smartfriendz/smartcore/images/smartcore-top.jpg

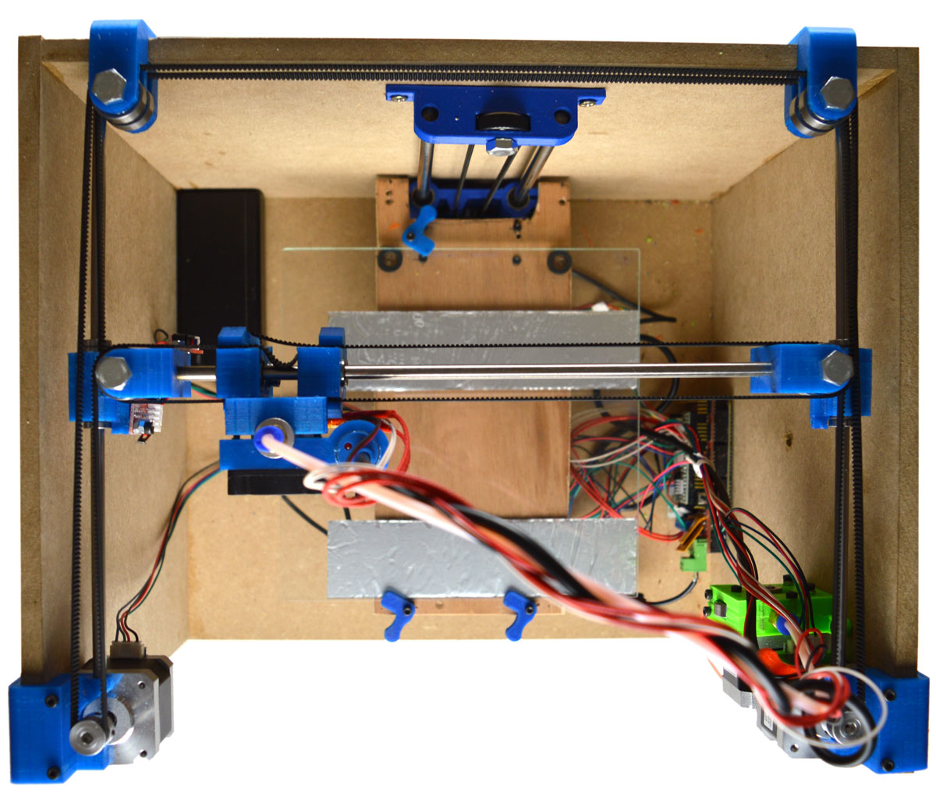
images/smartcore-top.jpg
