smartfriendz/smartcore/images/smartcore-tete.jpg

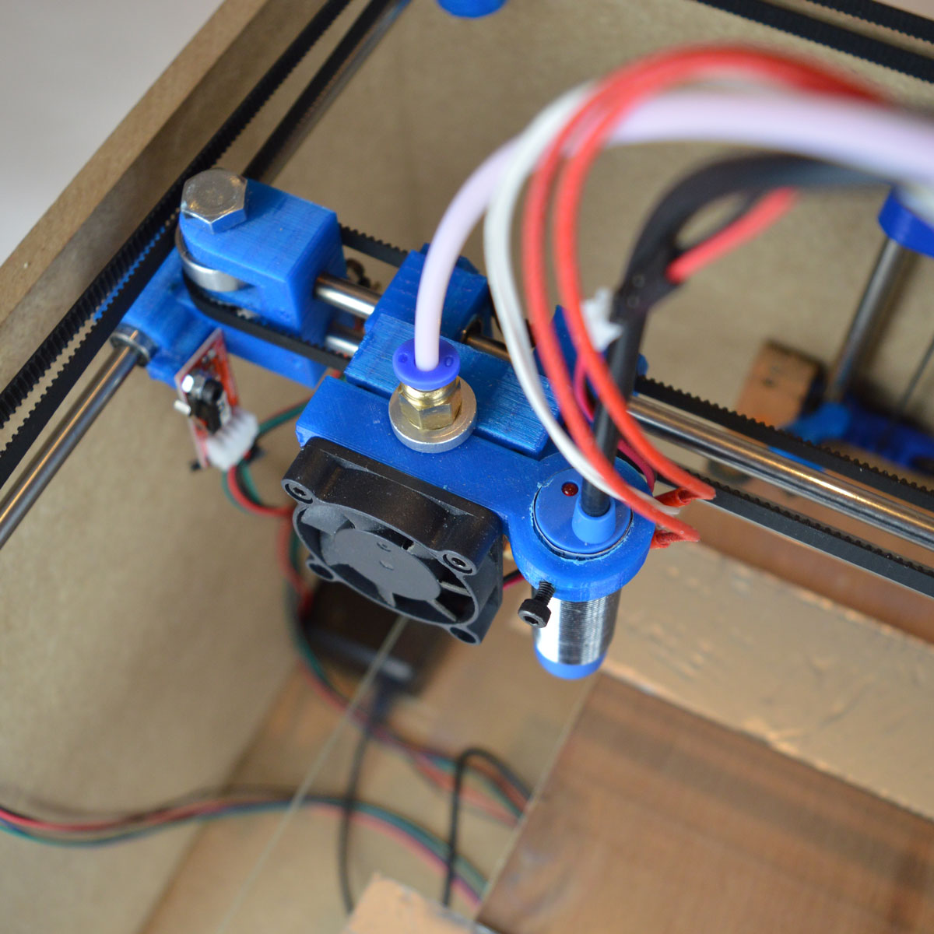
images/smartcore-tete.jpg
