smartfriendz/smartcore/README.md

# smartcore
the simple and cheap corexy from smartfriendz
