smartfriendz/smartcore/images/smartcore diagonal.jpg

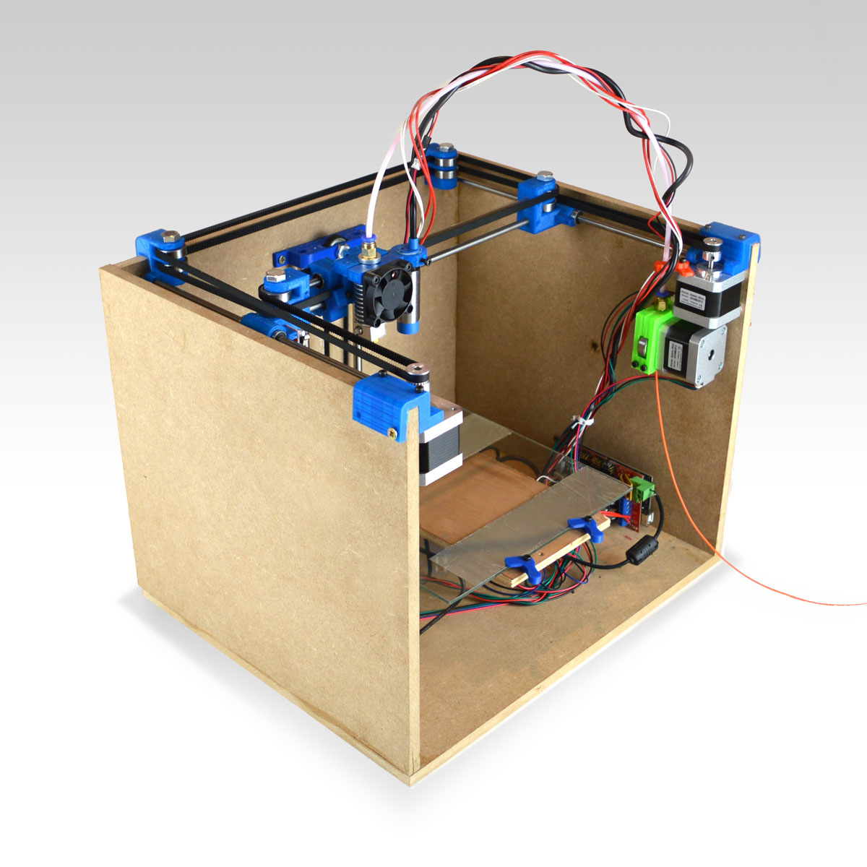
images/smartcore diagonal.jpg
