smartfriendz/smartcore/images/smartcore-front 220.jpg

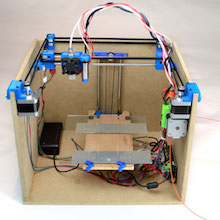
images/smartcore-front 220.jpg
