smartfriendz/smartcore/images/smartcore-sfeer.jpg

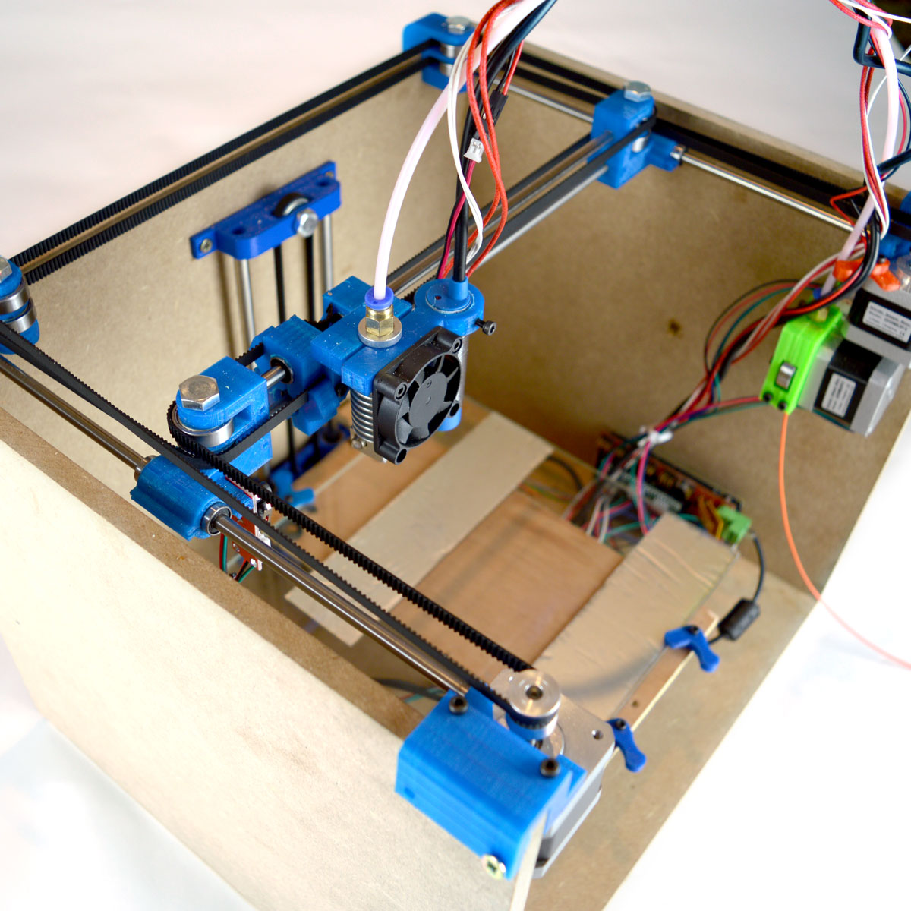
images/smartcore-sfeer.jpg
