smartfriendz/smartcore/stl/separate parts/head_8mmrods.stl

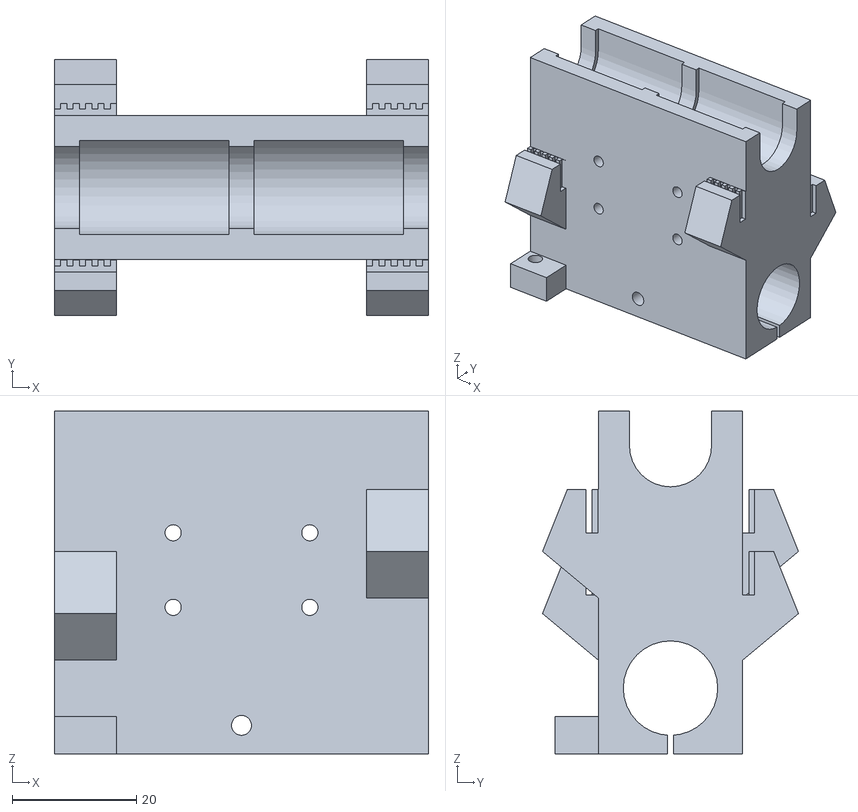
[picture p6: CAD file, 2015-06-15]
stl/separate parts/head_8mmrods.stl
60.2 x 41.2 x 55.2
