smartfriendz/smartcore/stl/smartrapcore_plate3.stl

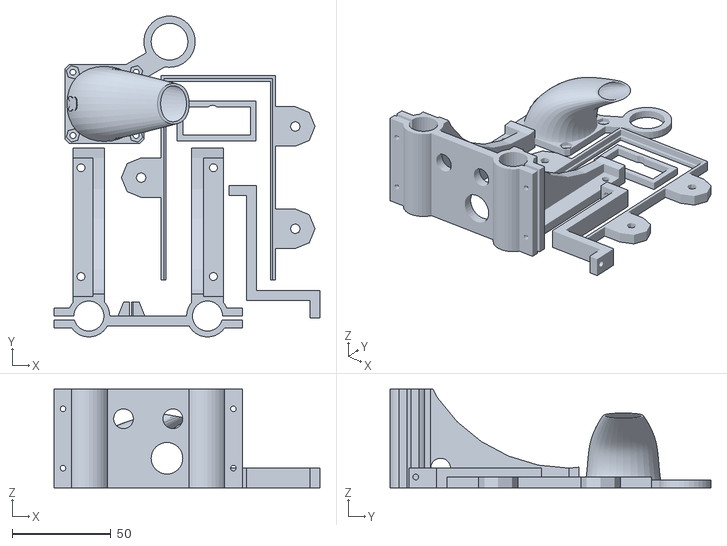
[picture p7: CAD file, 2015-06-17]
stl/smartrapcore_plate3.stl
134.5 x 162.4 x 50.0
