smartfriendz/smartcore/stl/separate parts/Zslide.stl

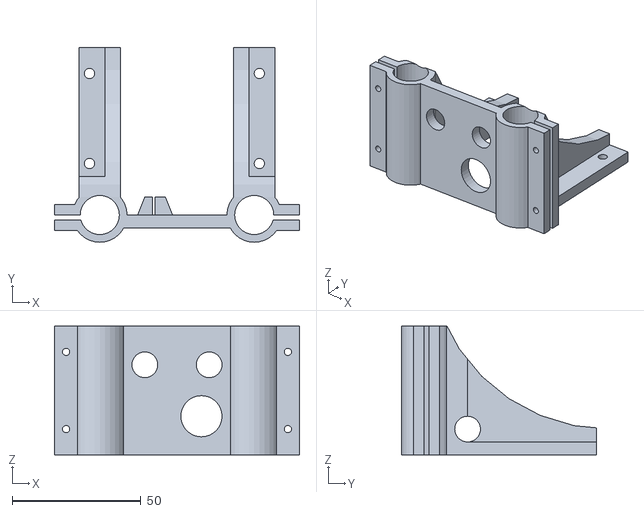
[picture p8: CAD file, 2015-06-10]
stl/separate parts/Zslide.stl
95.2 x 75.6 x 50.0
