smartfriendz/smartcore/stl/smartrapcore_plate1.stl

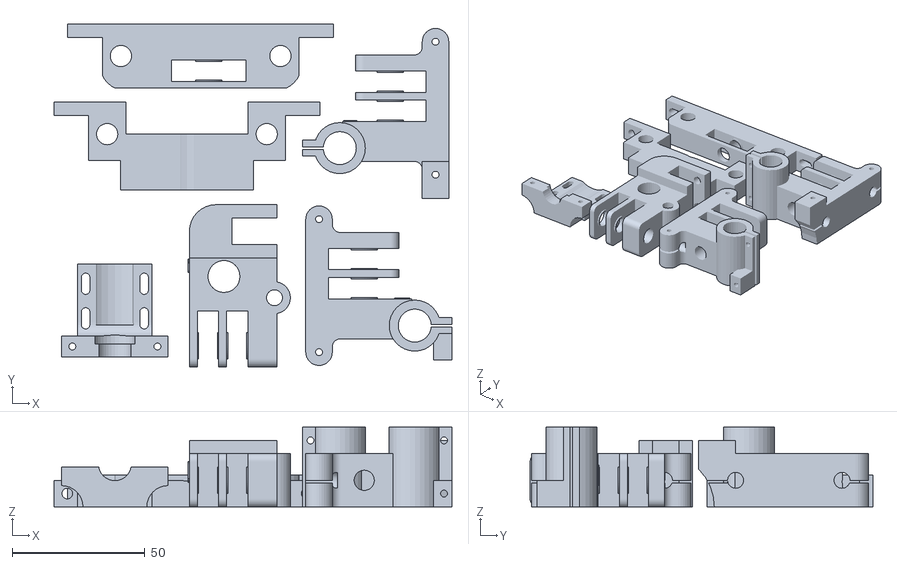
[picture p9: CAD file, 2015-06-17]
stl/smartrapcore_plate1.stl
149.7 x 128.9 x 30.0
