smartfriendz/smartcore/stl/separate parts/extruder_mk8_bottom.stl

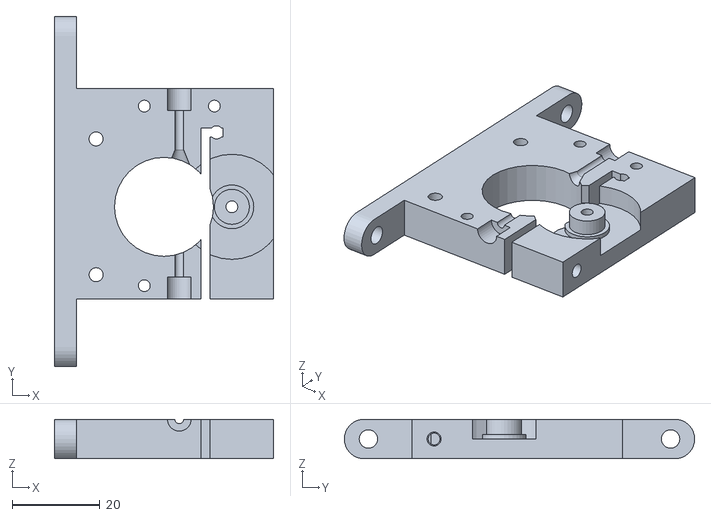
[picture p10: CAD file, 2015-06-10]
stl/separate parts/extruder_mk8_bottom.stl
50.0 x 80.0 x 9.00
