smartfriendz/smartcore/stl/smartrapcore_plate2.stl

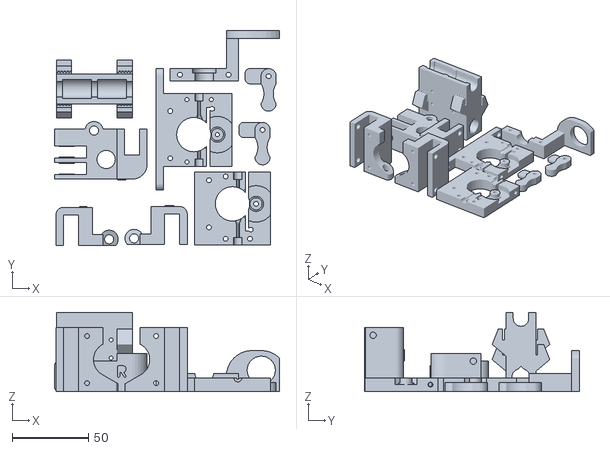
[picture p11: CAD file, 2015-06-17]
stl/smartrapcore_plate2.stl
148.0 x 141.2 x 52.0
