smartfriendz/smartcore/stl/separate parts/spoolholder32.stl

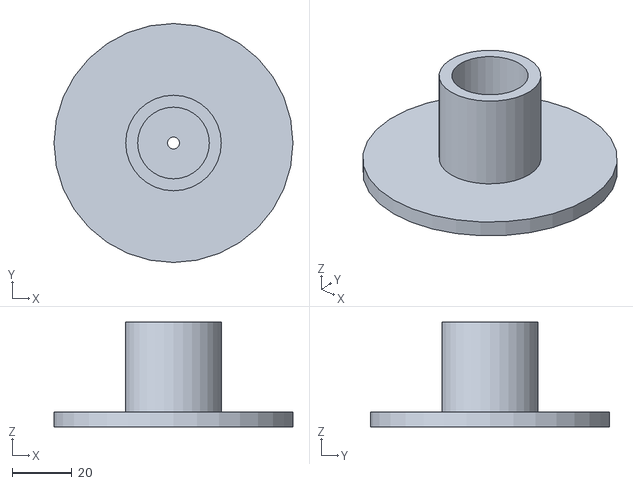
[picture p12: CAD file, 2015-06-10]
stl/separate parts/spoolholder32.stl
80.0 x 80.0 x 35.0
