smartfriendz/smartcore/stl/separate parts/extruder_mk8_top.stl

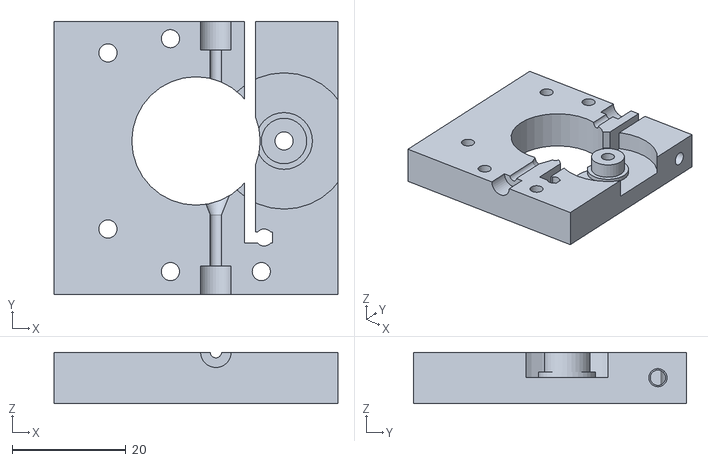
[picture p13: CAD file, 2015-06-10]
stl/separate parts/extruder_mk8_top.stl
50.0 x 48.0 x 9.00
