smartfriendz/smartcore/stl/separate parts/Yslide_left.stl

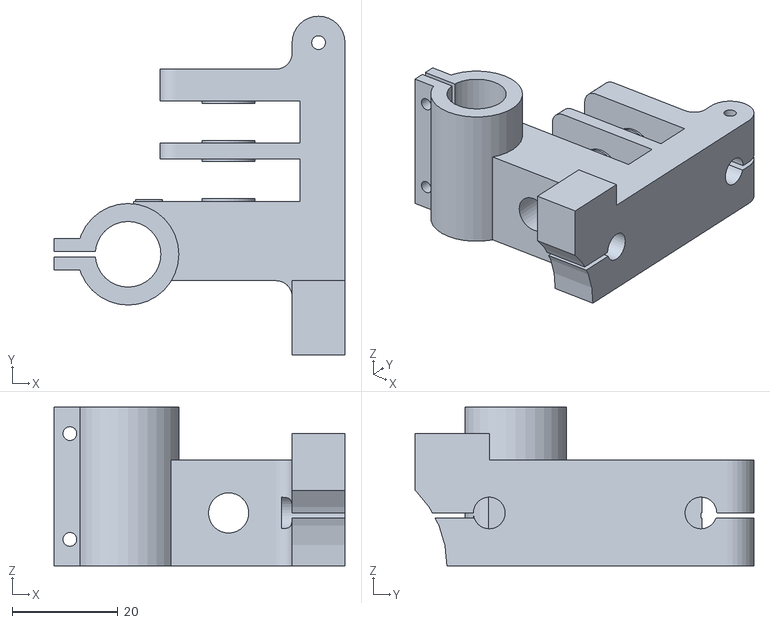
[picture p14: CAD file, 2015-06-10]
stl/separate parts/Yslide_left.stl
55.0 x 64.0 x 30.0
