smartfriendz/smartcore/stl/separate parts/Yslide_right.stl

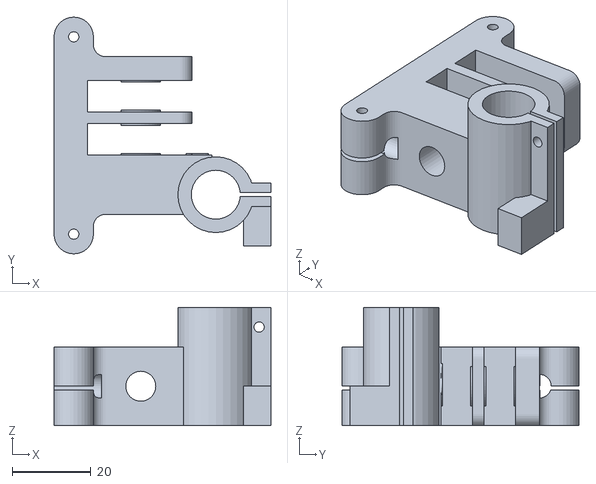
[picture p15: CAD file, 2015-05-28]
stl/separate parts/Yslide_right.stl
55.0 x 60.0 x 30.0
