smartfriendz/smartcore/stl/separate parts/supportcable bigsize.stl

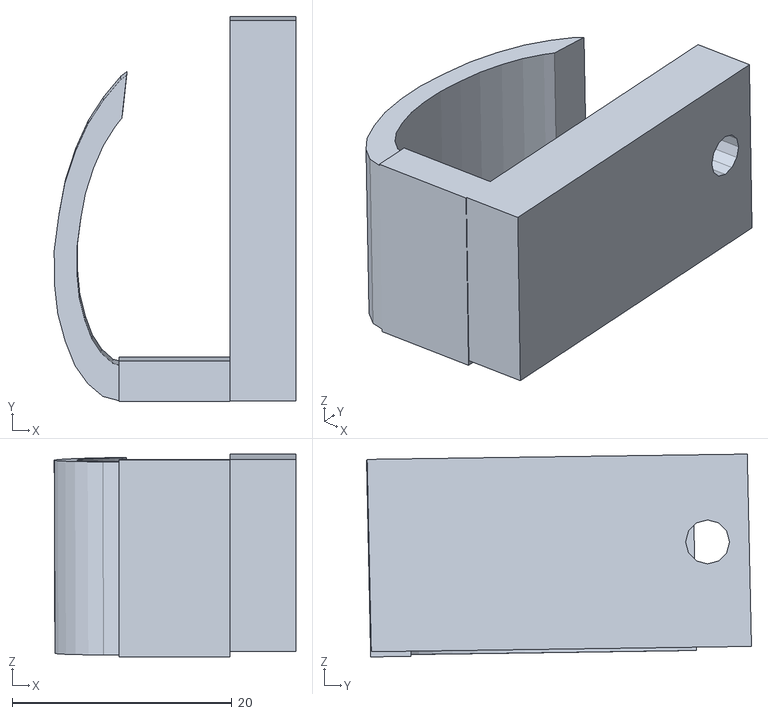
[picture p16: CAD file, 2015-05-28]
stl/separate parts/supportcable bigsize.stl
22.0 x 35.1 x 18.5
