smartfriendz/smartcore/stl/separate parts/ramps_support.stl

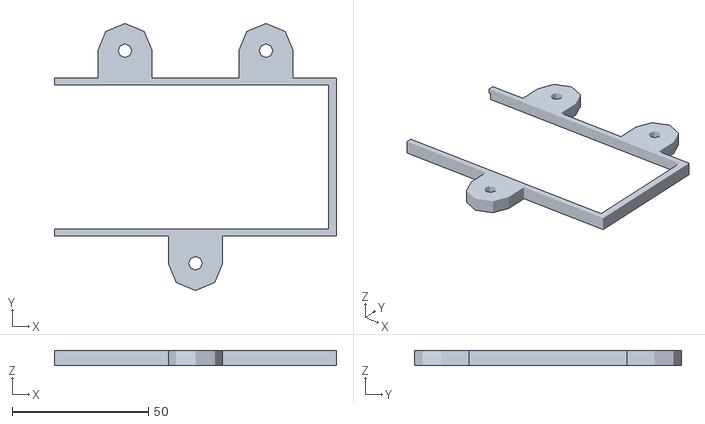
[picture p17: CAD file, 2015-05-28]
stl/separate parts/ramps_support.stl
103.5 x 98.0 x 5.50
