smartfriendz/smartcore/stl/separate parts/head.stl

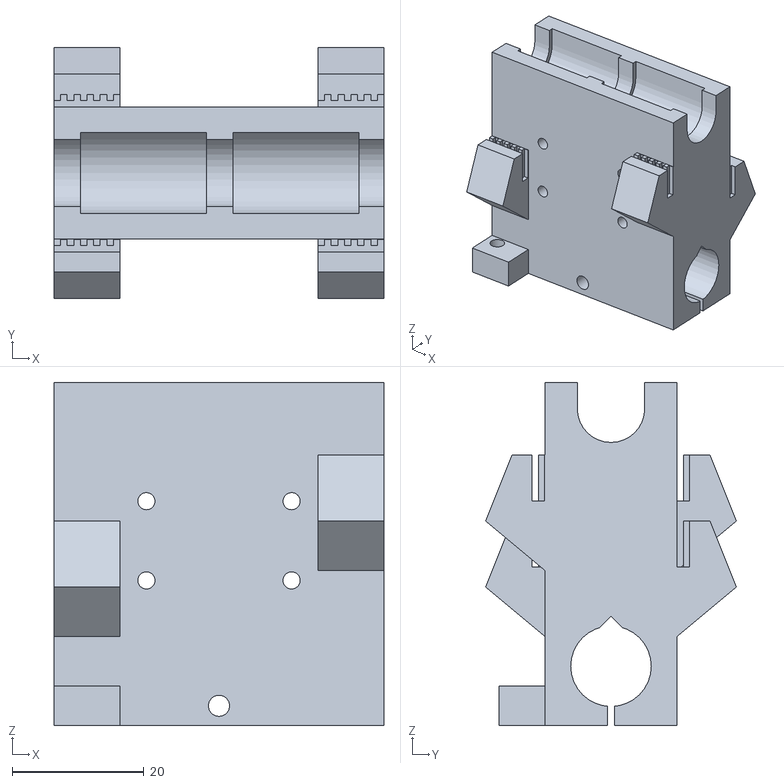
[picture p18: CAD file, 2015-05-28]
stl/separate parts/head.stl
50.0 x 38.0 x 52.0
