smartfriendz/smartcore/stl/separate parts/fixalim.stl

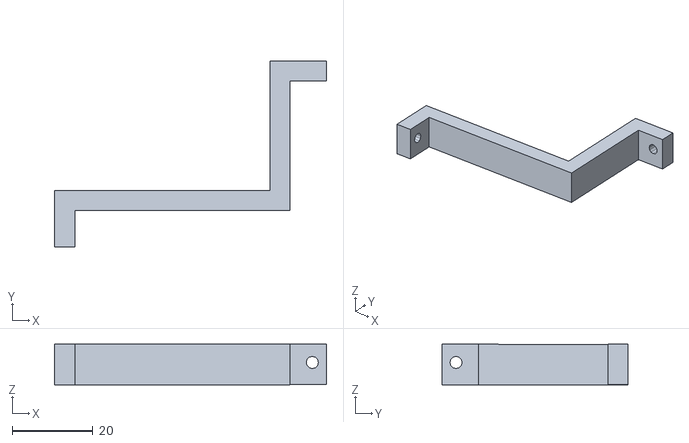
[picture p19: CAD file, 2015-05-28]
stl/separate parts/fixalim.stl
67.2 x 46.0 x 10.0
