smartfriendz/smartcore/stl/separate parts/endstopYsupport.stl

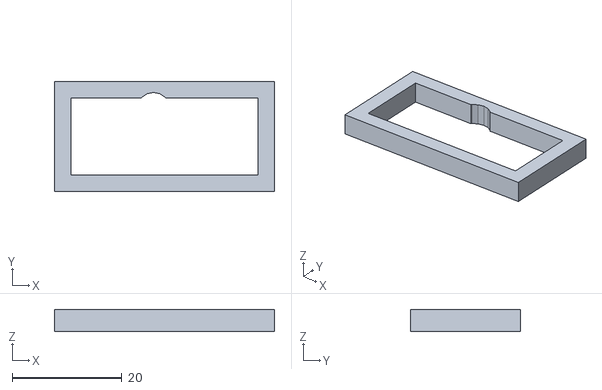
[picture p20: CAD file, 2015-05-28]
stl/separate parts/endstopYsupport.stl
40.0 x 20.0 x 4.00
