smartfriendz/smartcore/stl/separate parts/jhead_attach.stl

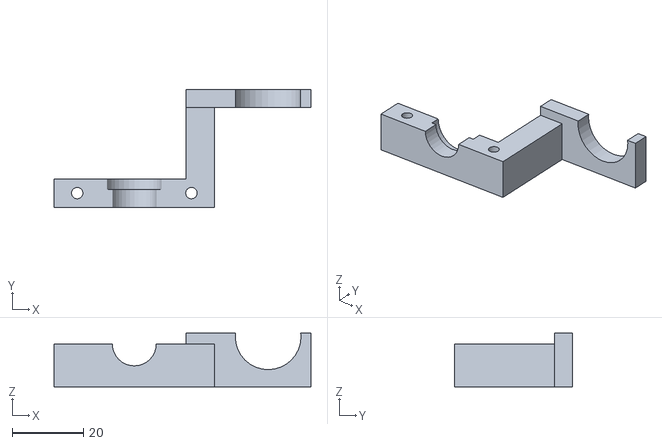
[picture p21: CAD file, 2015-05-18]
stl/separate parts/jhead_attach.stl
72.0 x 33.0 x 15.0
