smartfriendz/smartcore/stl/separate parts/XYbearings_left.stl

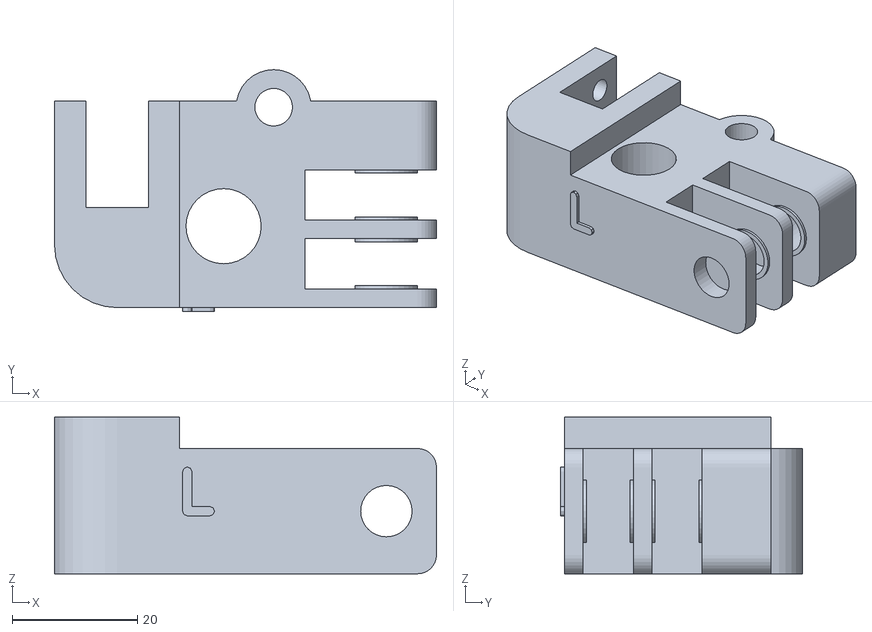
[picture p22: CAD file, 2015-05-18]
stl/separate parts/XYbearings_left.stl
61.0 x 38.6 x 25.0
