smartfriendz/smartcore/stl/separate parts/XYmotor_right.stl

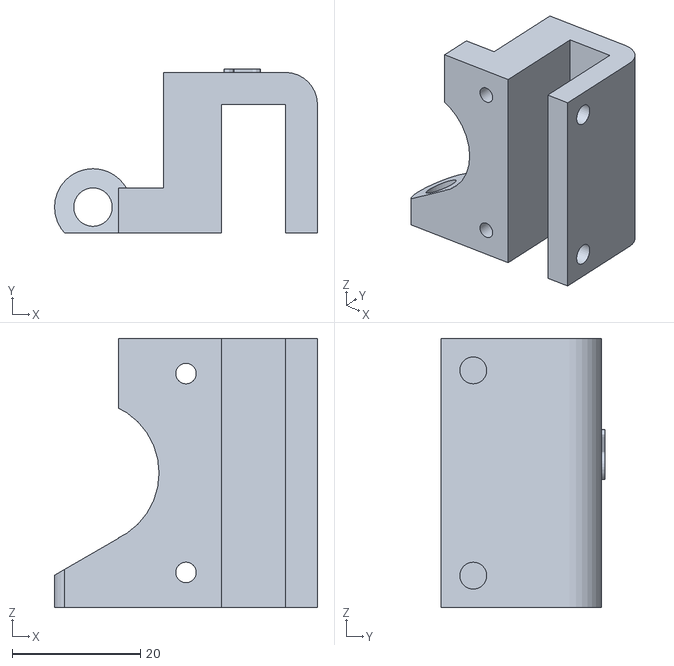
[picture p23: CAD file, 2015-05-18]
stl/separate parts/XYmotor_right.stl
41.0 x 25.5 x 42.0
