smartfriendz/smartcore/stl/separate parts/jhead_adaptor.stl

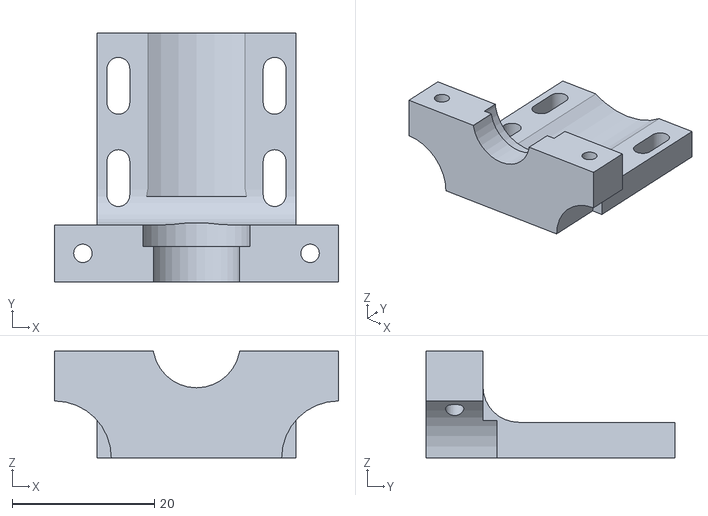
[picture p24: CAD file, 2015-05-09]
stl/separate parts/jhead_adaptor.stl
40.0 x 35.0 x 15.0
