smartfriendz/smartcore/(list of files, cad)

Other CAD files:
stl/separate parts/XYmotor_left.stl
stl/separate parts/XYbearings_right.stl
sources/blender/sc_12_plates.blend
sources/blender/smartrapcore.blend
