smartfriendz/smartcore/(threads)

Thread 6 (2015-03-13):

Wrong placement of zTop

chertykov, 2015-03-13:
With **Box wood thickness** different from 10 placement of zTop is wrong.

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

JeffreyRodriguez, 2015-07-11:
The Z-top bracket is fixed, but the rest of the Z assembly is still misplaced:
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

JeffreyRodriguez, 2015-07-11:
Same with smaller wall thicknesses, the upper block is fine, but the assembly is misplaced.

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

Thread 8 (2015-03-27):

XY Rod diameter isn't used in some parts

quillford, 2015-03-27:
I'm working on converting a Printrbot Simple into a smartcore. I started to print some parts and found that some of the parts don't seem to adjust with the OpenJSCAD parameters. I noticed this specifically with the XY rod diameter on [this part](http://img42.com/Xncpr).

quillford, 2015-04-04:
Apparently this was just my printer or the filament I was using that made the holes too small.

Closed 2015-04-04.

Thread 11 (2015-05-10):

Printed parts plate different from assembly

quillford, 2015-05-10:
Since 1.2, the printed parts plate generated with OpenJSCAD is different than the assembly. Specifically I noticed this with the hotend carriage piece

Closed 2015-08-14.

Thread 14 (2015-05-14):

1.2 - XY slide LM8uu spots don't fit

lordofhyphens, 2015-05-14:
In the XY slide, selecting a XY rod size of 8 generates 2 spots of length 19mm (which is correct for LM6UU) instead of 24mm (LM8UU)

lordofhyphens, 2015-05-15:
Currently the JSCAD does not work at all for 8mm rods w/o this fix.

JeffreyRodriguez, 2015-07-11:
This is now fixed in master, although the head is a bit thick for M3x30mm. Considering adding sunken nuts to compensate and improve functionality/aesthetics.

Recommend closing along with PR #15.

Thread 18 (2015-07-06):

Y-Slide bearing screws don't fit with 8mm rods

JeffreyRodriguez, 2015-07-06:
As of the current `master` commit 3e6421612dbdf49b78023343f389bd47144afa30, 8mm Y bearings cannot be properly secured with screws. The screw head and nut are not flush, but blocked by the wall.

6mm
====
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

8mm
====
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

The outer wall is also very thin and prone to breakage.

Fix
===
I propose extending the screw plate. There's at least 6mm extra room between the y-slide screw plate and the frame.

laxde, 2015-07-06:
Also the placement letter (R/L) aren't visible  on version "1.2.4 june 17 2015". I think this is a related problem with the screw plate, i.e. it's the expansion of LM6UU to LM8UU without taking care of the surrounding things.

JeffreyRodriguez, 2015-07-06:
Fixed in PR #19

Closed 2015-07-07.

Thread 21 (2015-07-07):

8mm X-rods on Y-Slide interfere with screws

JeffreyRodriguez, 2015-07-07:
6mm X-rods:
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

8mm X-rods:
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

I have a fix for this - moving the screw blocks out according to X-rod diameter. I will be sending a PR later this evening.

Closed 2015-07-10.

Thread 27 (2016-05-22):

when building for rod sizes 10mm, motor mounts are broken

mds99, 2016-05-22:
i'm trying to build using 10mm rods, and it looks like code need more fixes than just add LM sizes.
motor mounts render not usable, slide has weak bearing housings.
