smartfriendz/smartcore/(commit log)

2014-10-30 initialisation
    first upload : current openjscad source… rest following
2014-11-02 2 rods sizes / adjust Z system
    better to have Z rods bigger. we can adjust separately now.
    advanced All Z axis.
    now walls are right.
2014-11-09 update v 0.9
    almost complete.
    generation printing plates, options..etc
    [plate_1.stl, plate_2.stl, plates.blend]
2014-11-28 updates + marlin
    some stl out but still not definitive, so , still work in progress
    marlin setup.
    [Configuration.h, Configuration_adv.h, Menu Plans.xlsx, Zbottom.stl, Zslide.stl, Ztop.stl, all-24.stl, bearing_Hat.stl]
2015-01-21 version 0.9
    first complete version .
    [608Inter.stl, Configuration.h, YslideLeft.stl, YslideRight.stl, Zbottom.stl, Zslide.stl, Ztop.stl, all-24.stl]
2015-01-22 updates on version 0.9
    back to old slide. need more adjustments
    new head support.. was too high
    [Zslide.stl, directdrive_iddle_10mm_bottom.stl, directdrive_iddle_10mm_top.stl, jheadAttach.stl, jheadsupport.stl, plates.blend, smartcore_09_plate_1.stl, smartcore_09_plate_2.stl]
2015-01-23 new direct extruder test
    testing direct extruder. no bowden.
    its about 300 grammes on the head ans with this new system it’s nothing.
    [Configuration.h, direct_extruder_bottom.stl, direct_extruder_top.stl, inductivesupport.stl, smartcore__.blend]
2015-01-24 update direct extruder
    changed dimensions so it works good now with 1.75, mk7 and 3mm ptfe
    blocking.
    put holes through on Slides so screws reinforce bearing supports.
    changed inductive sensor place.
    [YslideLeft.stl, YslideRight.stl, direct_extruder_bottom.stl, direct_extruder_top.stl, slidesY.stl]
2015-01-25 update two extruder types
    now we can have bowden or direct extrusion with the new extruder
    [Configuration.h, extruder_bowden_bottom.stl, extruder_bowden_top.stl]
2015-01-28 version 0.9.1
    generated plate now works .
    lot of little debugs
    we have bowden or direct extrusion now
    [Configuration.h, extruder_bowden_bottom.stl, extruder_bowden_top.stl, smartcore.scad]
2015-01-30 version 0.9.2
    separate stl out
    version in jscad
    config slic3r
    [Configuration.h, XYbearings_left.stl, XYbearings_right.stl, XYbearings_support.stl, XYmotor_left.stl, XYmotor_right.stl, XYmotor_support.stl, Yslide_left.stl]
2015-02-11 0.9.1
    lot of changes.. we are near a nice new version. eventually, the first
    version will disappear.
    stl parts are well oriented .
    [608Inter.stl, Configuration.h, XYbearings_left.stl, XYbearings_right.stl, XYbearings_support.stl, XYmotor_left.stl, XYmotor_right.stl, XYmotor_support.stl]
2015-02-11 changes motorxy
    was too hard to print. changed some angles.
    [XYmotor_left.stl, XYmotor_right.stl, plates.blend, smartcore_plate_2.stl]
2015-02-19 0.9.1.9
    new Bottom and top. replaced the bearings XY to be aligned.
    [XYbearings_left.stl, XYbearings_right.stl, XYmotor_left.stl, XYmotor_left_rod.stl, XYmotor_right.stl, XYmotor_right_rod.stl, Yslide_left.stl, Yslide_right.stl]
2015-02-25 version 1.0.0.1
    first published version on thingiverse, youmagine, etc..
    start kits.
    [Configuration.h, XYbearings_left.stl, XYbearings_right.stl, XYmotor_left.stl, XYmotor_left_rod.stl, XYmotor_right.stl, XYmotor_right_rod.stl, Yslide_left.stl]
2015-02-26 1.0.2
    was not good when we changed wood thickness. now it’s repaired.
2015-02-28 1.0.2 and 1.0.3
    moonier changes. parts bad oriented and change for 8mm rods xy version
    [smartrapcore_plate1.stl, smartrapcore_plate2.stl, smartrapcore_plates.blend]
2015-03-04 Added support for 10 and 12 mm Z rods.
2015-03-06 version 1.0.6
    reinforced Y rod support on bearingsXY
    added screw holes for Y rod support on slideY
    changed endstopY support size ( didn’t touch the motor)
    now we have only one slideY with endstop support
    [Configuration.h]
2015-03-07 added belt length calculation (estimated) added z-axis threaded rod option
2015-03-07 updated nut size for z-threaded rod default to z-axis belt drive
2015-03-07 updated assembly view with z-axis threaded rod option
2015-03-09 Updated Z rod assembly with 2 slides or one
2015-03-10 1.0.7
    integration threaded rod for Z with option 2 Z axis for large boxes.
    [XYbearings_left.stl, XYbearings_right.stl, Yslide_left.stl, Yslide_right.stl, smartrapcore_plate1.stl, smartrapcore_plate2.stl, smartrapcore_plates.blend]
2015-03-12 1.0.8
    debugging 2 merges about Z. One is Z rods until 12mm an other is Z
    threaded rod.
2015-03-13 10.0.9
    new plate 2 : Ztop bearing hole was too small.
    [Configuration.h, smartcore.scad, smartrapcore_plate2.stl, smartrapcore_plates.blend]
2015-05-09 version 1.2
    -> bearingsXY : now fix on the side ,more easy to build and far more
    solid on the Y rod ( it was breaking too easy)
    -> Head : new one piece part , was problem with assembly. when you fix,
    parts are not aligned and bearings become hard. was not stable enough
    -> new inductive support : more solid and lower
    -> new slideY : far more solid, Xrods are further away , we have now an
    iso assembly (allmost)
    -> new Zslide : more solid, bigger, we fix the plank with 4 wood screws
    . no need to counterdrill anymore.
    [Configuration.h, XYbearings_left.stl, XYbearings_right.stl, Yslide_left.stl, Yslide_right.stl, Zslide.stl, Ztop.stl, extruder_bowden_bottom_mk7.stl]
2015-05-10 changed plate 2
    was a cube under .. bad printing .
    [smartrapcore_plate2.stl]
2015-05-10 update 1.2
    was alignment default between Yslides and XYbearings
    [XYbearings_left.stl, XYbearings_right.stl, Yslide_left.stl, Yslide_right.stl, sc_12_plates.blend, smartrapcore2.blend, smartrapcore_plate1.stl, smartrapcore_plate2.stl]
2015-05-18 version 1.2.1
    new places for endstop X and Y . Now the y is screwed on the box and
    the X is on the head, so we don’t have too loose cables on the left
    anymore.
    new parts : head, yslidelfet,yslideright.
    [XYbearings_left.stl, XYbearings_right.stl, XYmotor_left.stl, XYmotor_right.stl, Yslide_left.stl, Yslide_right.stl, head.stl, jhead_attach.stl]
2015-05-28 version 1.2.2
    endstops X/Y change place. X is under head now and Y is on the right
    wall with a new Yslide right with a form under.
    [Yslide_left.stl, Yslide_right.stl, endstopYsupport.stl, fixalim.stl, head.stl, ramps_support.stl, sc_12_plates.blend, smartrapcore_plate1.stl]
2015-06-04 bug in Yslide Left . hole to attach X rod bottom screw was not long enough
2015-06-10 cleaning and synchro stls.
    added some extra parts still not in openjscad ( not merged) .
    [XYbearings_left.stl, XYbearings_right.stl, XYmotor_left.stl, XYmotor_right.stl, Yslide_left.stl, Yslide_right.stl, Zbottom.stl, Zslide.stl]
2015-06-12 version 1.2.3 - accessories
    added some accessories for the basic kit.
    [sc_12_plate1.stl, sc_12_plate2.stl, sc_12_plate3.stl]
2015-06-12 update 8mm XY rods now working
2015-06-15 just little update
    [smartrapcore.blend]
2015-06-15 slidey screw holes not long enough.
    [sc_12_plate1.stl, sc_12_plates.blend]
2015-06-15 debug head for 8mm rods option. was too small on top.
    [head_8mmrods.stl]
2015-06-16 updated firmware, profiles.
    [Configuration.h, Configuration_adv.h, Menu Plans.xlsx]
2015-06-16 cleaning folders
    [sc_12_plate1.stl, sc_12_plate2.stl, sc_12_plate3.stl, smartrapcore_plate1.stl, smartrapcore_plate2.stl, smartrapcore_plate3.stl]
2015-06-17 update 1.2.4 : new inductive sensor holder. bigger Zslide , new fanduck ( brunobellamy) . new plates .
    [Configuration.h, sc_12_plates.blend, smartrapcore_plate1.stl, smartrapcore_plate2.stl, smartrapcore_plate3.stl]
2015-07-02 up slide 8mm rods
2015-07-06 Fixes #18 - Y-Slide bearing screws don't fit with 8mm rods
2015-07-06 Moved the screws out 1mm.
2015-07-07 Using X-Rod diameter to position X-Rod fixing screws.
2015-07-07 Unified the format for X-rods screws a bit.
